gbhug5a/Reflow-Hot-Plate-and-Controller/Hotplate/Pictures/08-Hot-plate-with-saw-blade.jpg

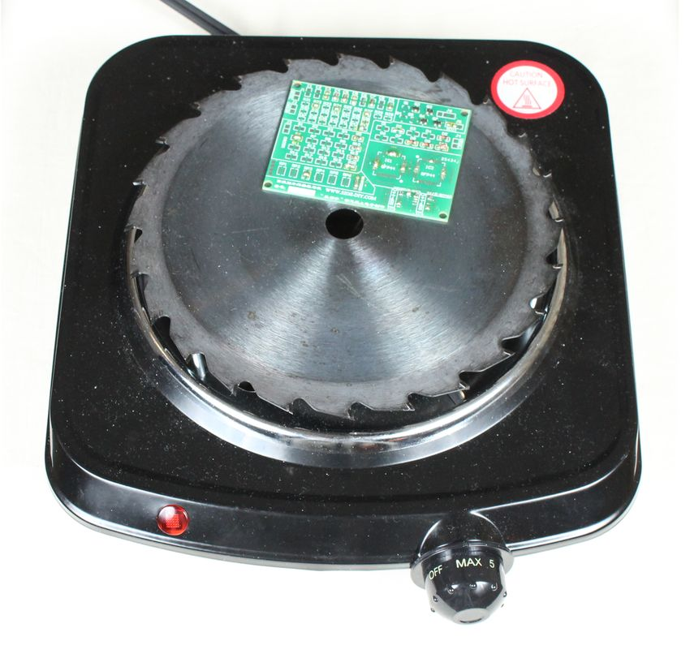
Hotplate/Pictures/08-Hot-plate-with-saw-blade.jpg
