gbhug5a/Reflow-Hot-Plate-and-Controller/Hotplate/Pictures/04-Machine-screws.jpg

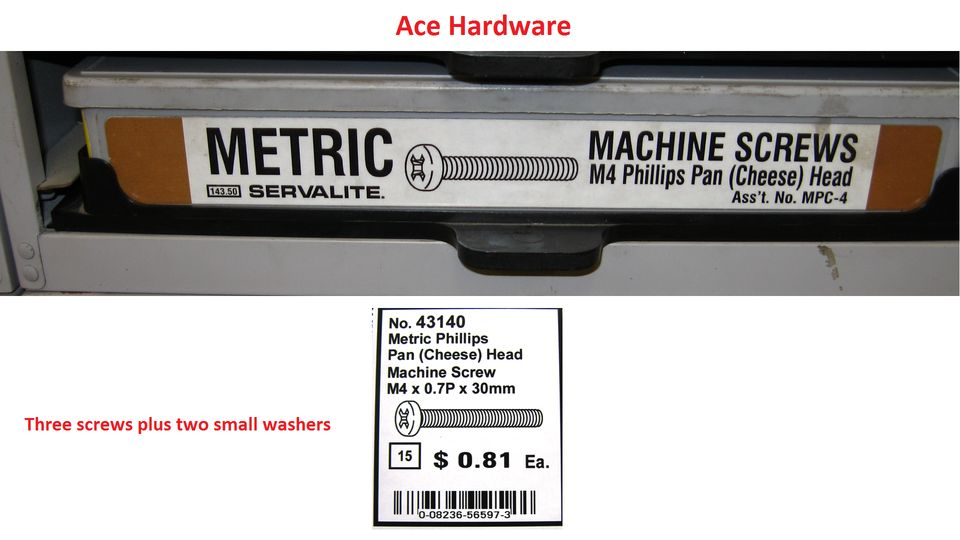
Hotplate/Pictures/04-Machine-screws.jpg
