gbhug5a/Reflow-Hot-Plate-and-Controller/Hotplate/Links.pdf

Walmart Mainstays Single Burner Hot Plate - Model ME102-U2 - 120VAC, 1000W

https://www.walmart.com/ip/Mainstays-Black-Easy-to-Clean-Spacing-Saving-Single-Burner/53264468

Avanti 7.25-inch Circular Saw Blade - Model A0724A

https://www.homedepot.com/p/Avanti-7-1-4-in-x-24-Teeth-Framing-Saw-Blade-A0724A/202035217

https://www.walmart.com/ip/7-1-4-24-Teeth-Circular-Saw-Blade-DIABLO-A0724A/824939062

Metric Machine Screws (3 ea) - M4-0.07 x 30mm

https://www.acehardware.com/ (in store only)

https://www.homedepot.com/p/M4-0-7-x-30-mm-Stainless-Pan-Head-Phillips-Metric-Machine-Screw-2-Pack-842908/204283763
