gbhug5a/Reflow-Hot-Plate-and-Controller/Controller/Controller-Schematic.jpg

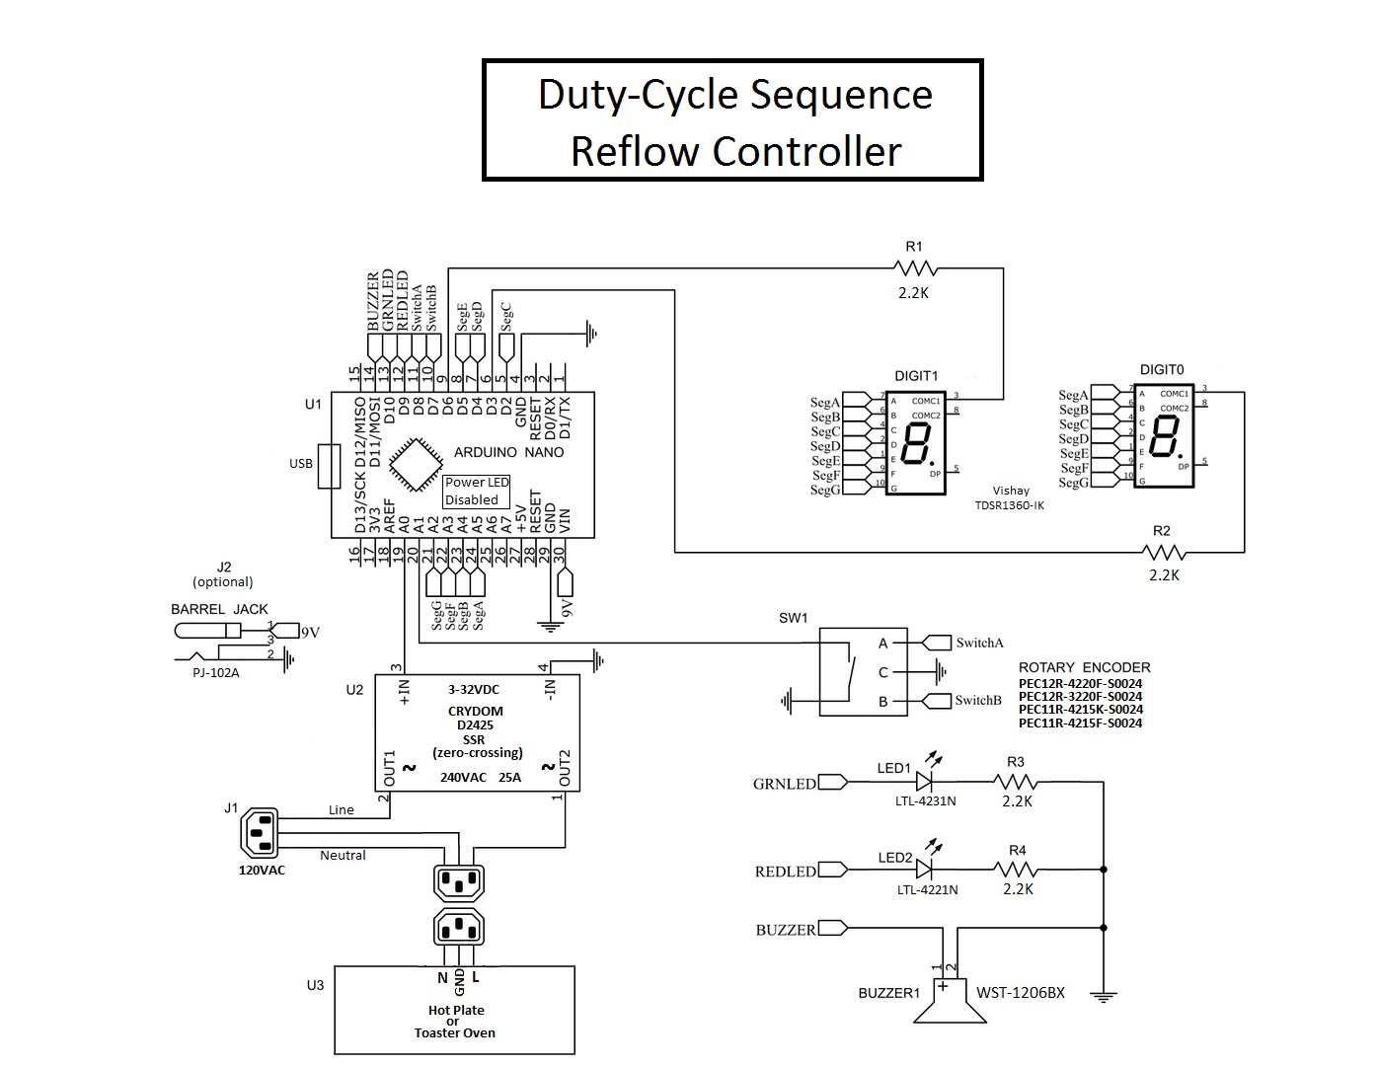
Controller/Controller-Schematic.jpg
