gbhug5a/Reflow-Hot-Plate-and-Controller/Controller/Pictures/AC-box-with-SSR.jpg

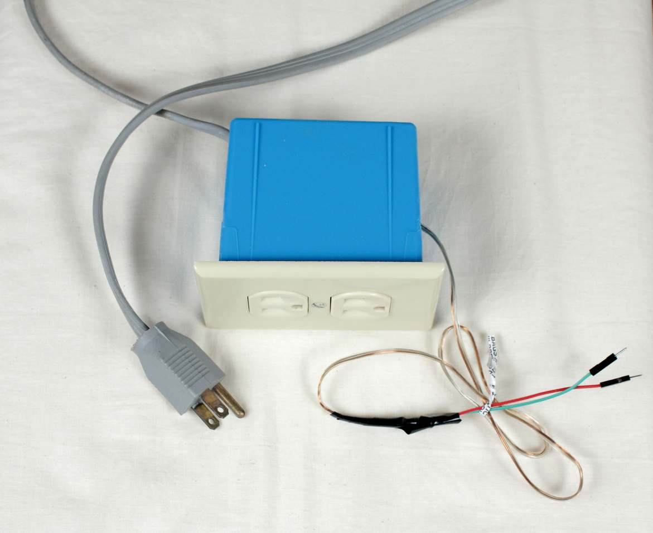
Controller/Pictures/AC-box-with-SSR.jpg
