gbhug5a/Reflow-Hot-Plate-and-Controller/Controller/Pictures/Controller.jpg

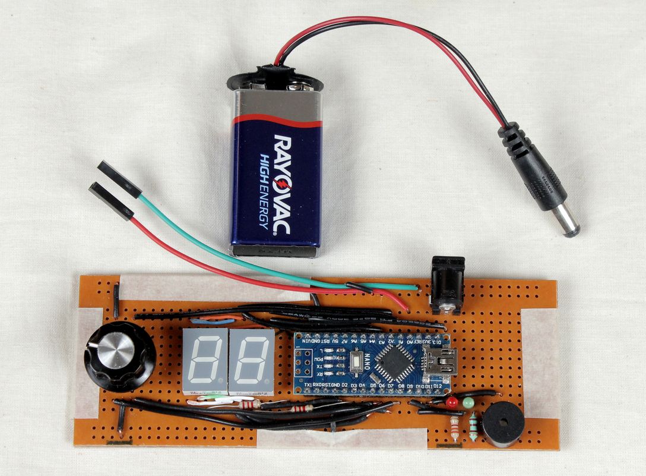
Controller/Pictures/Controller.jpg
