gbhug5a/Reflow-Hot-Plate-and-Controller/Controller/Pictures/TM-902C.jpg

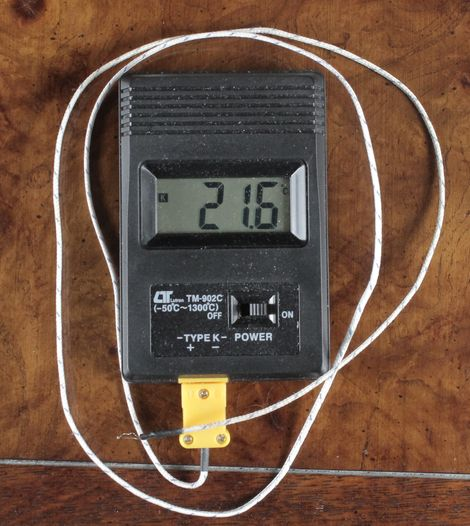
Controller/Pictures/TM-902C.jpg
