gbhug5a/Reflow-Hot-Plate-and-Controller/Hotplate/Pictures/01-Walmart-hot-plate.jpg

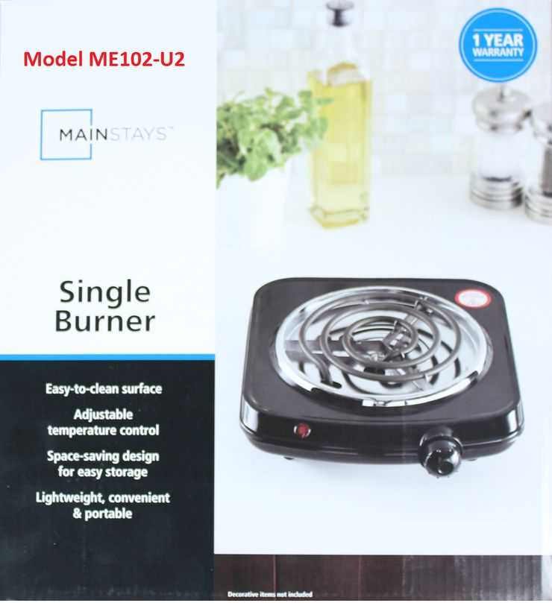
Hotplate/Pictures/01-Walmart-hot-plate.jpg
