gbhug5a/Reflow-Hot-Plate-and-Controller/Hotplate/Pictures/02-Hot-plate.jpg

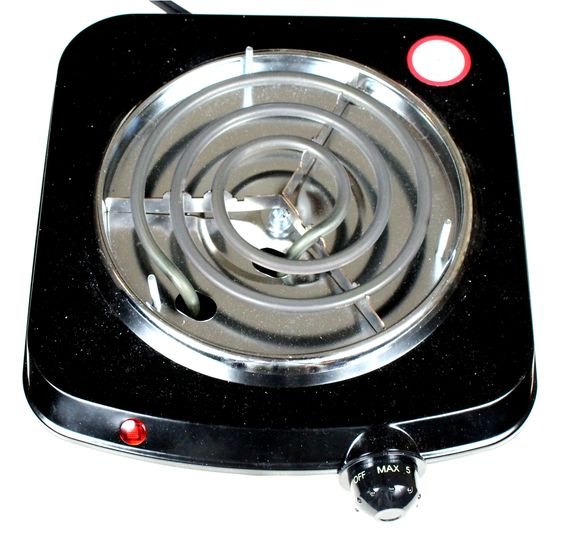
Hotplate/Pictures/02-Hot-plate.jpg
