gbhug5a/Reflow-Hot-Plate-and-Controller/Hotplate/Pictures/03-Home-Depot-saw-blade.jpg

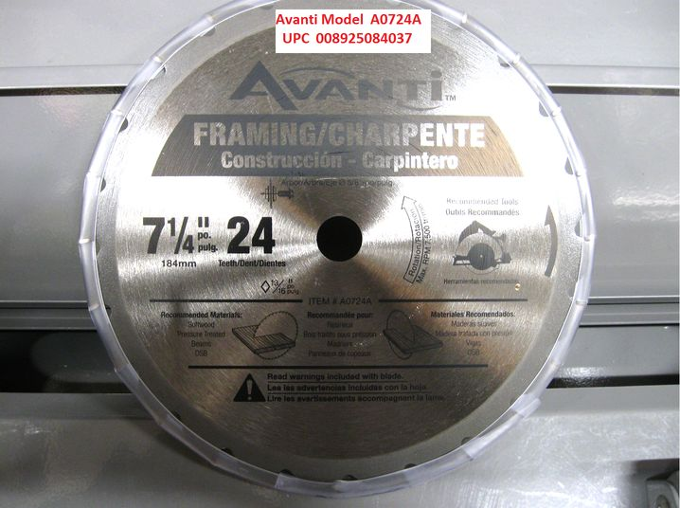
Hotplate/Pictures/03-Home-Depot-saw-blade.jpg
