gbhug5a/Reflow-Hot-Plate-and-Controller/Hotplate/Pictures/05-Bottom-cover.jpg

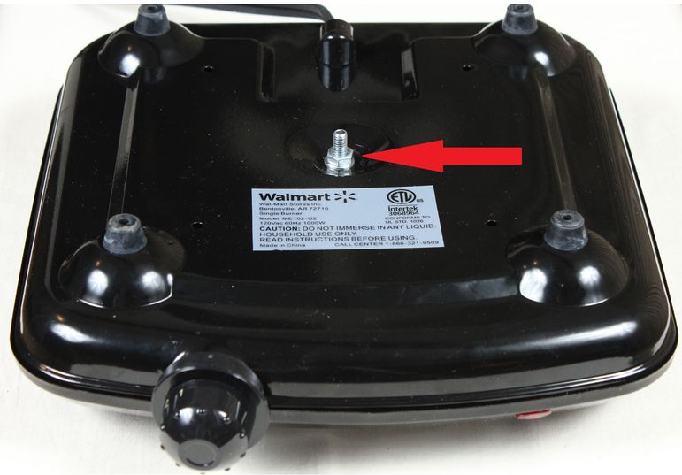
Hotplate/Pictures/05-Bottom-cover.jpg
