gbhug5a/Reflow-Hot-Plate-and-Controller/Hotplate/Pictures/06-Screw-replacement.jpg

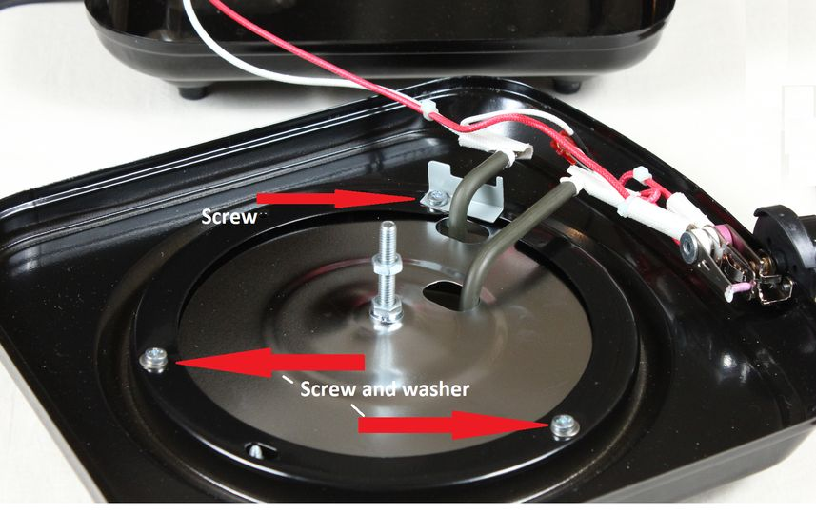
Hotplate/Pictures/06-Screw-replacement.jpg
