gbhug5a/Reflow-Hot-Plate-and-Controller/Hotplate/Pictures/07-Raised-saw-blade.jpg

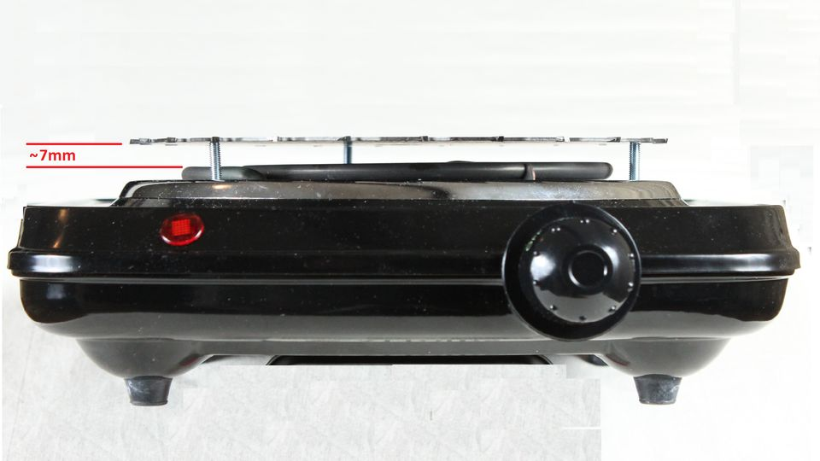
Hotplate/Pictures/07-Raised-saw-blade.jpg
