gbhug5a/Reflow-Hot-Plate-and-Controller/Hotplate/Pictures/09-Reflow-power-cycles.jpg

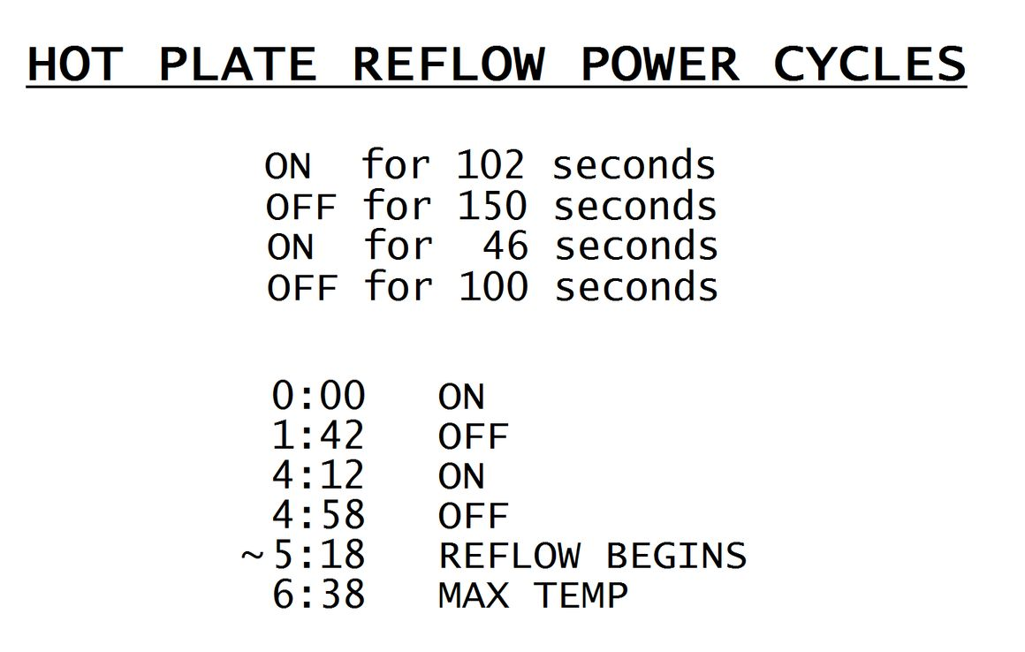
Hotplate/Pictures/09-Reflow-power-cycles.jpg
