gbhug5a/Reflow-Hot-Plate-and-Controller/Hotplate/Pictures/10-Hotplate-Temp-Profile.jpg

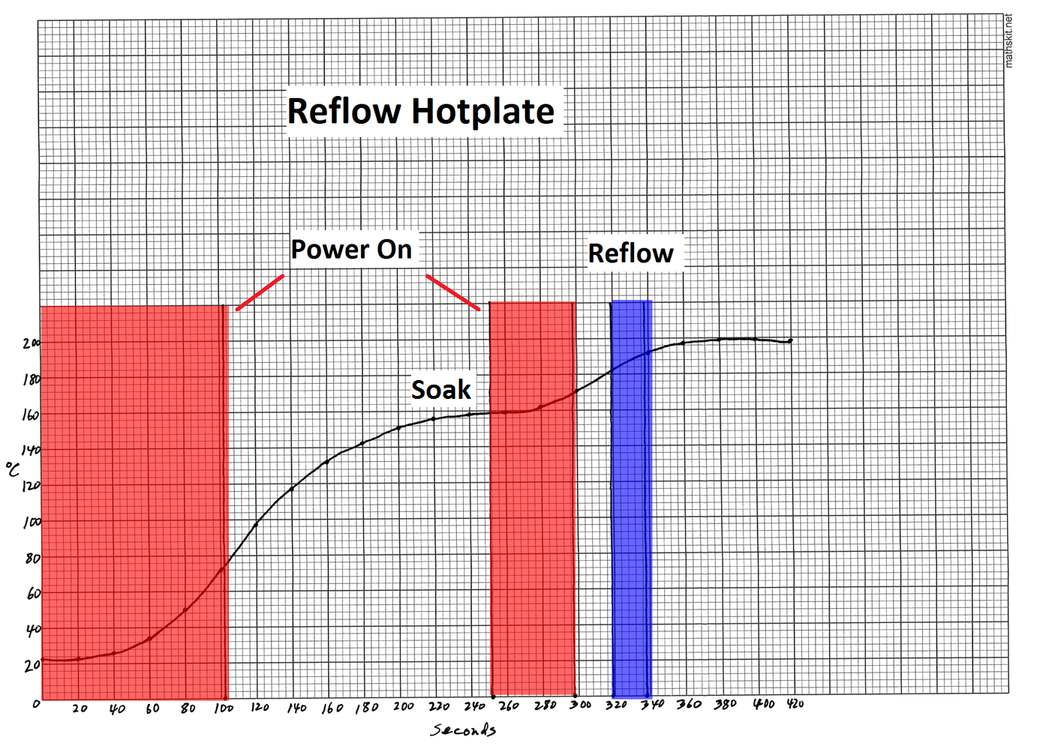
Hotplate/Pictures/10-Hotplate-Temp-Profile.jpg
